zaidpirwani/Serial-Terminal-CCN-Mini-Project/Project Report and Pics/20140101_114749 -opt.jpg

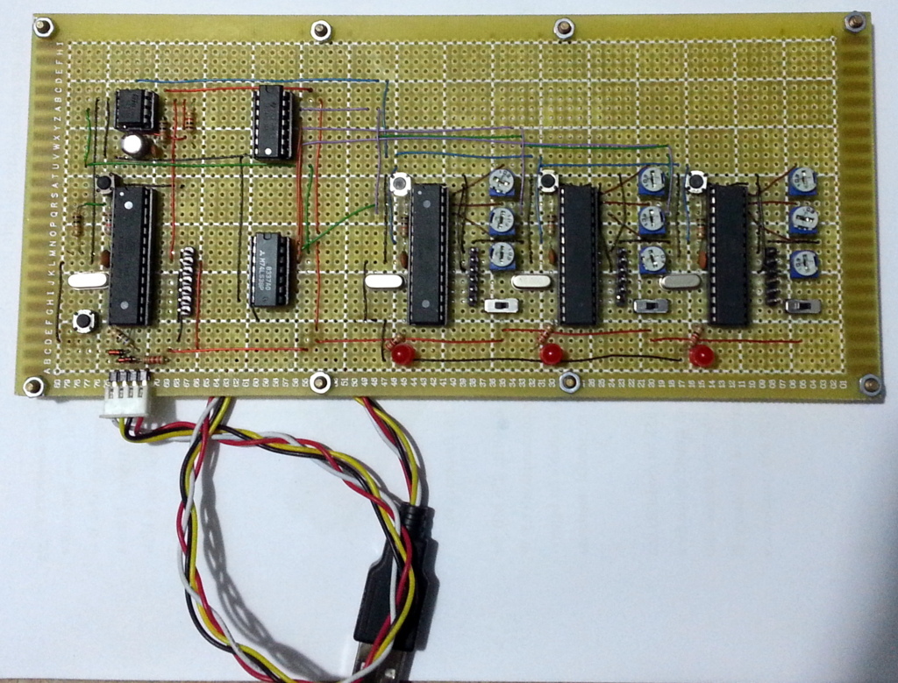
Project Report and Pics/20140101_114749 -opt.jpg
