zaidpirwani/Serial-Terminal-CCN-Mini-Project/Circuit-Schematic-Simulation/network.PDF

U1

R1

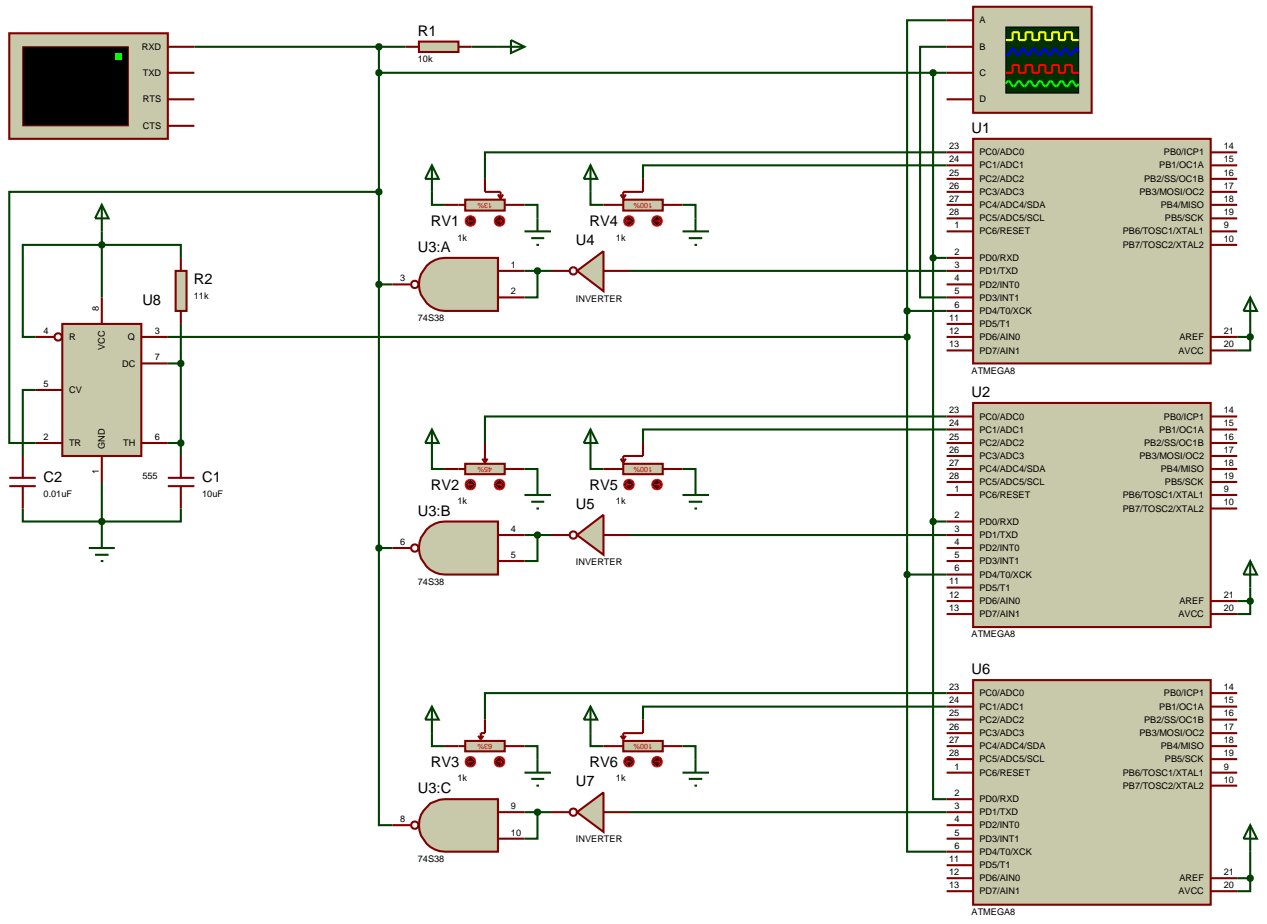
[picture p10: page 1]
