zaidpirwani/Serial-Terminal-CCN-Mini-Project/(list of files, drawings)

Other design files:
Circuit-Schematic-Simulation/network.DSN
